yossato/Watzhdog/README.md

# Watzhdog
This device wakes you up when you fall a sleep while you are meeting, studing or working, using a vibration motor.
