yossato/Watzhdog/3D_models/Watzhdog_Pen.step

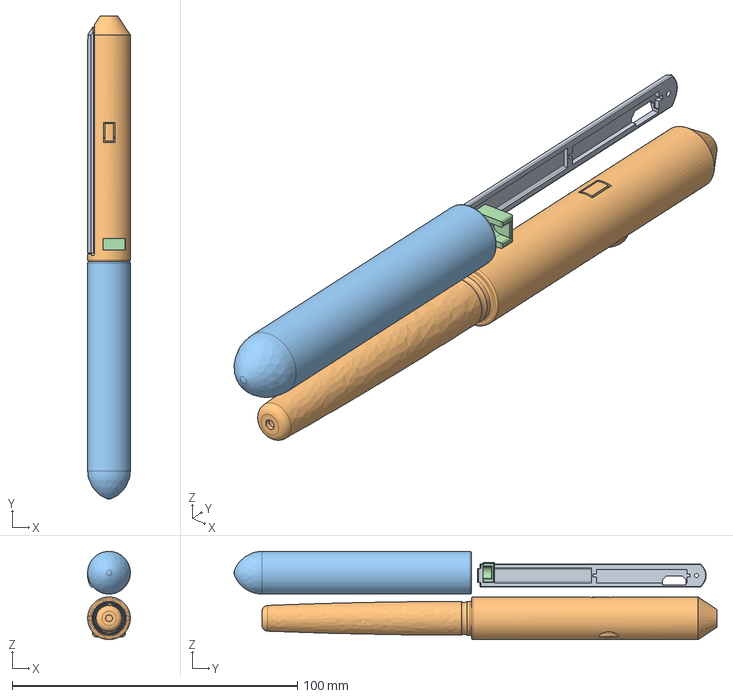
[picture p1: CAD file, 2018-08-12]
3D_models/Watzhdog_Pen.step
15.0 x 169.5 x 31.0 mm
