yossato/Watzhdog/circuit/main.brd

## EAGLE design circuit/main.brd (2018-08-12)

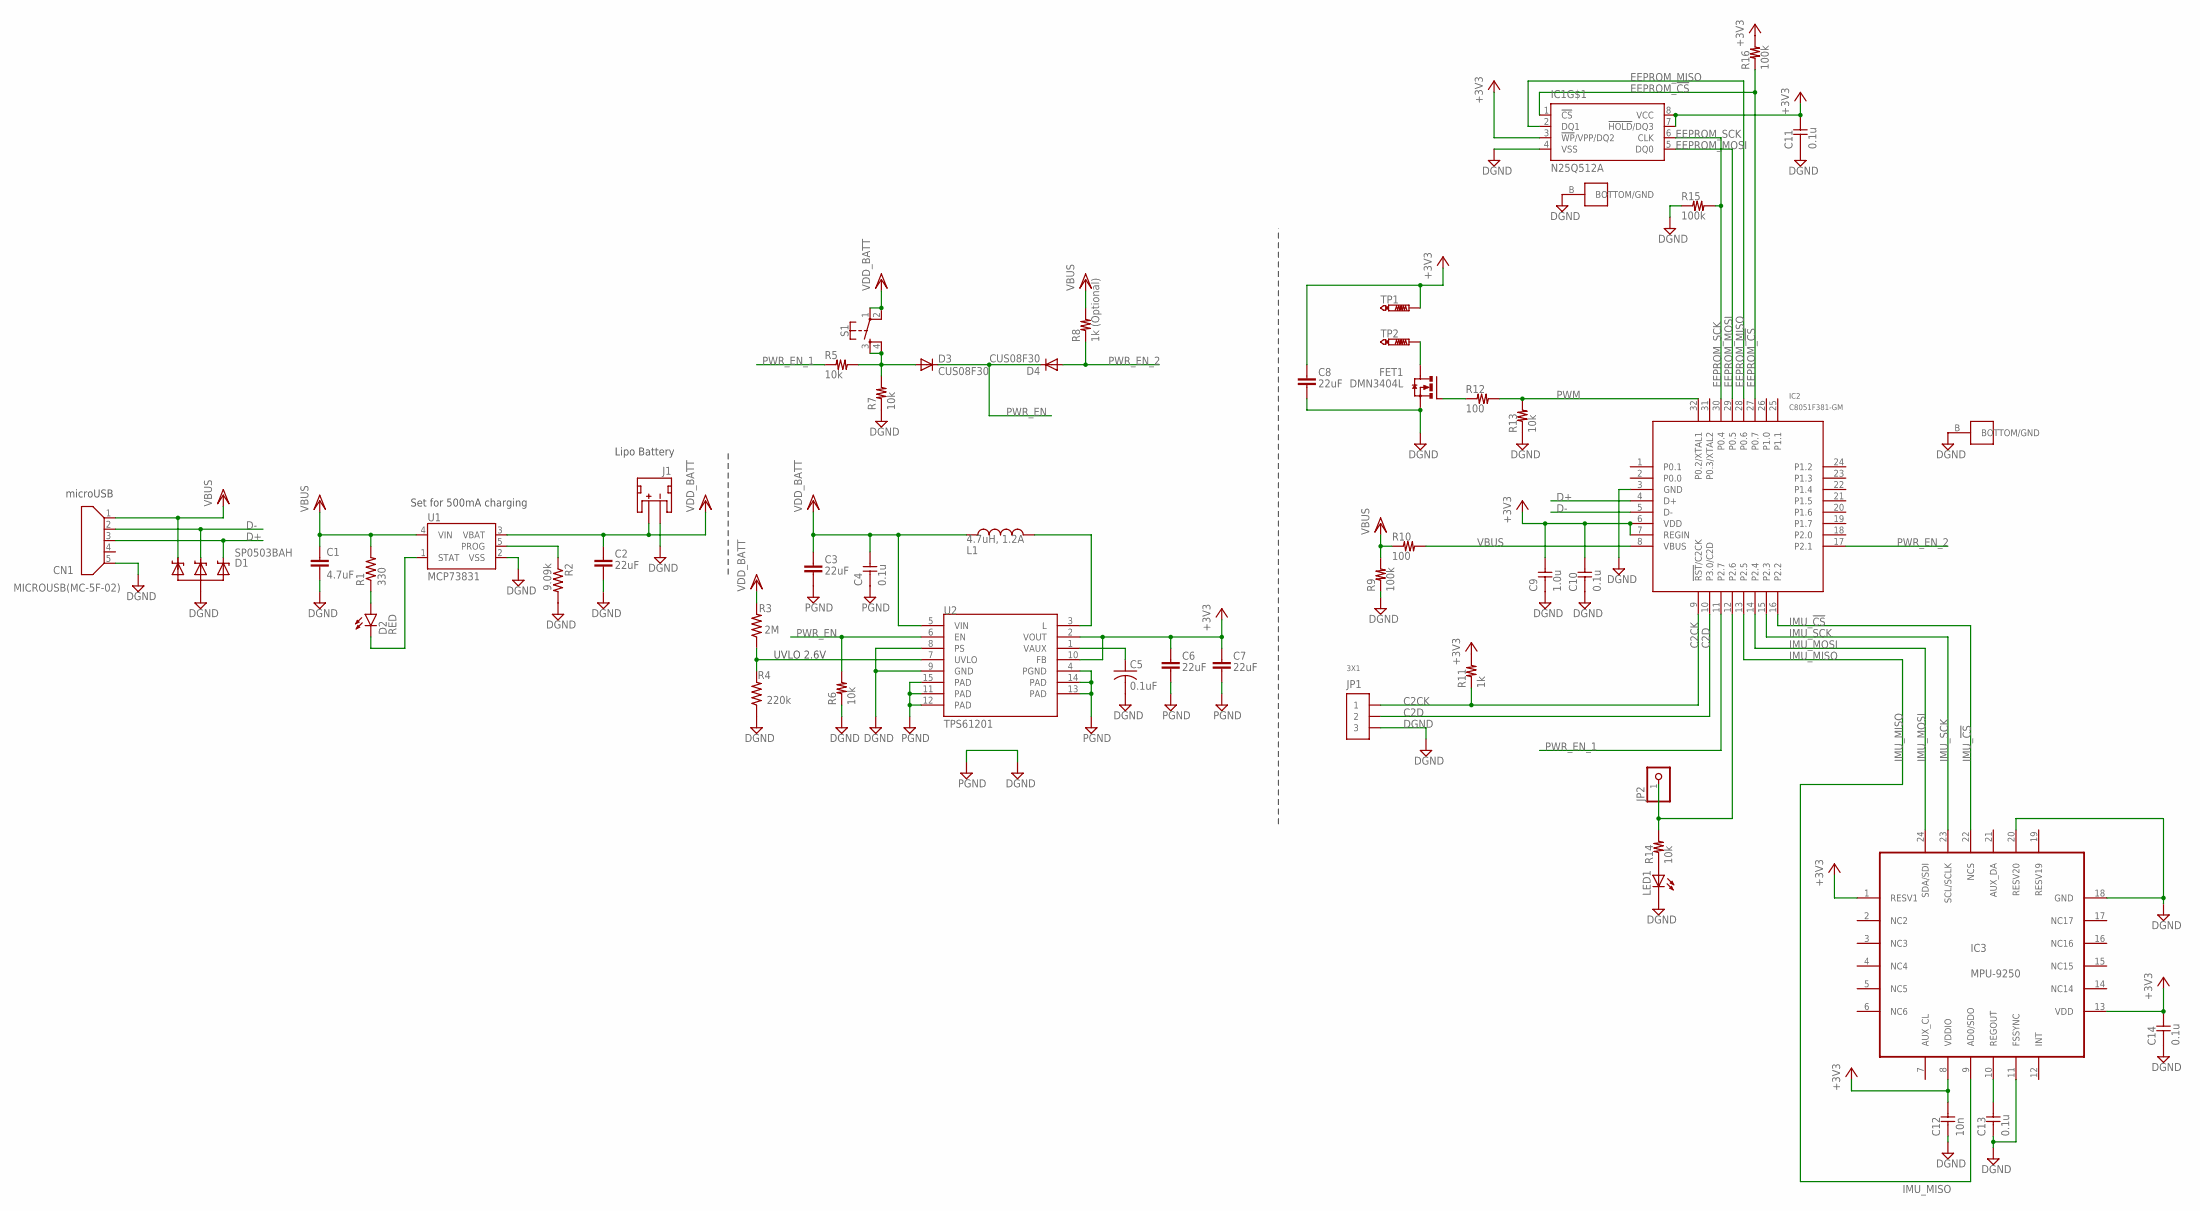
[picture p2: schematic main.sch]

Parts:
C1: 4.7uF; 0603-CAP
C2, C3, C6, C7, C8: 22uF; 0805
C4, C10, C11, C13, C14: 0.1u; 1005
C5: 0.1uF; C0402K
C9: 1.0u; 1005
C12: 10n; 1005
CN1: MICROUSB(MC-5F-02)
D1: SP0503BAH; SOT143
D2: RED; LED-0603
D3, D4: CUS08F30; SOD323-W
FET1: DMN3404L; SOT23
IC1: N25Q512A; V-PDFN-8
IC2: C8051F381-GM; QFN32
IC3: MPU-9250; QFN-24
J1: JST; JST-2-SMD
JP1: 3X1; MA3-1
JP2: PINHD-1X1; 1X01
L1: 4.7uH, 1.2A; CDRH2D09
LED1: LED1608O; 1608-OLI
R1: 330; R0402
R2: 9.09k; R0402
R3: 2M; R0402
R4: 220k; R0402
R5, R6, R7, R13, R14: 10k; 1005
R8: 1k (Optional); 1005
R9, R15, R16: 100k; 1005
R10, R12: 100; 1005
R11: 1k; 1005
S1: MOMENTARY-SWITCH-SPST-2-SMD-4.6X2.8MM; TACTILE_SWITCH_SMD_4.6X2.8MM
TP1, TP2: PTR1TP10R; TP10R
U1: MCP73831; SOT23-5
U2: TPS61201; QFN-10_PAD

Connections:
+3V3: C6.1, C7.1, C8.1, C9.P$2, C10.P$2, C11.P$2, C12.P$2, C14.P$2, IC1.3 (!WP!/VPP/DQ2), IC1.7 (!HOLD!/DQ3), IC1.8 (VCC), IC2.6 (VDD), IC2.7 (REGIN), IC3.1 (RESV1), IC3.8 (VDDIO), IC3.13 (VDD), R11.P$2, R16.P$2, TP1.TP, U2.2 (VOUT), U2.10 (FB)
C2CK: IC2.9 (!RST!/C2CK), JP1.1, R11.P$1
C2D: IC2.10 (P3.0/C2D), JP1.2
D+: CN1.3, D1.2, IC2.4 (D+)
D-: CN1.2, D1.3, IC2.5 (D-)
DGND: C1.2, C2.2, C3.2, C4.P$1, C5.2, C6.2, C7.2, C8.2, C9.P$1, C10.P$1, C11.P$1, C12.P$1, C13.P$1, C14.P$1, CN1.5, D1.1, FET1.S, IC1.4 (VSS), IC1.B (BOTTOM/GND), IC2.3 (GND), IC2.B (BOTTOM/GND), IC3.11 (FSSYNC), IC3.18 (GND), IC3.20 (RESV20), J1.1 (-), JP1.3, LED1.K, R2.2, R4.1, R6.P$1, R7.P$1, R9.P$1, R13.P$1, R15.P$1, U1.2 (VSS), U2.4 (PGND), U2.8 (PS), U2.9 (GND), U2.11 (PAD), U2.12 (PAD), U2.13 (PAD), U2.14 (PAD), U2.15 (PAD)
EEPROM_!CS: IC1.1 (!CS), IC2.27 (P0.7), R16.P$1
EEPROM_MISO: IC1.2 (DQ1), IC2.28 (P0.6)
EEPROM_MOSI: IC1.5 (DQ0), IC2.29 (P0.5)
EEPROM_SCK: IC1.6 (CLK), IC2.30 (P0.4), R15.P$2
IMU_!CS: IC2.16 (P2.2), IC3.22 (NCS)
IMU_MISO: IC2.13 (P2.5), IC3.9 (AD0/SDO)
IMU_MOSI: IC2.14 (P2.4), IC3.24 (SDA/SDI)
IMU_SCK: IC2.15 (P2.3), IC3.23 (SCL/SCLK)
LIN: L1.P$1 (1), U2.3 (L)
unnamed: D2.A, R1.1
unnamed: FET1.G, R12.P$1
unnamed: LED1.A, R14.P$1
unnamed: FET1.D, TP2.TP
unnamed: D3.A, R5.P$2, R7.P$2, S1.3, S1.4
unnamed: C13.P$2, IC3.10 (REGOUT)
unnamed: IC2.12 (P2.6), JP2.1, R14.P$2
unnamed: IC2.8 (VBUS), R10.P$2
PROG: R2.1, U1.5 (PROG)
PWM: IC2.32 (P0.2/XTAL1), R12.P$2, R13.P$2
PWR_EN: D3.C, D4.C, R6.P$2, U2.6 (EN)
PWR_EN_1: IC2.11 (P2.7), R5.P$1
PWR_EN_2: D4.A, IC2.17 (P2.1), R8.P$1
STAT: D2.C, U1.1 (STAT)
UVLO: R3.1, R4.2, U2.7 (UVLO)
VAUX: C5.1, U2.1 (VAUX)
VBUS: C1.1, CN1.1, D1.4, R1.2, R8.P$2, R9.P$2, R10.P$1, U1.4 (VIN)
VDD_BATT: C2.1, C3.1, C4.P$2, J1.2 (+), L1.P$2 (2), R3.2, S1.1, S1.2, U1.3 (VBAT), U2.5 (VIN)

Notes on the sheet:
Set for 500mA charging
microUSB
Lipo Battery
UVLO 2.6V

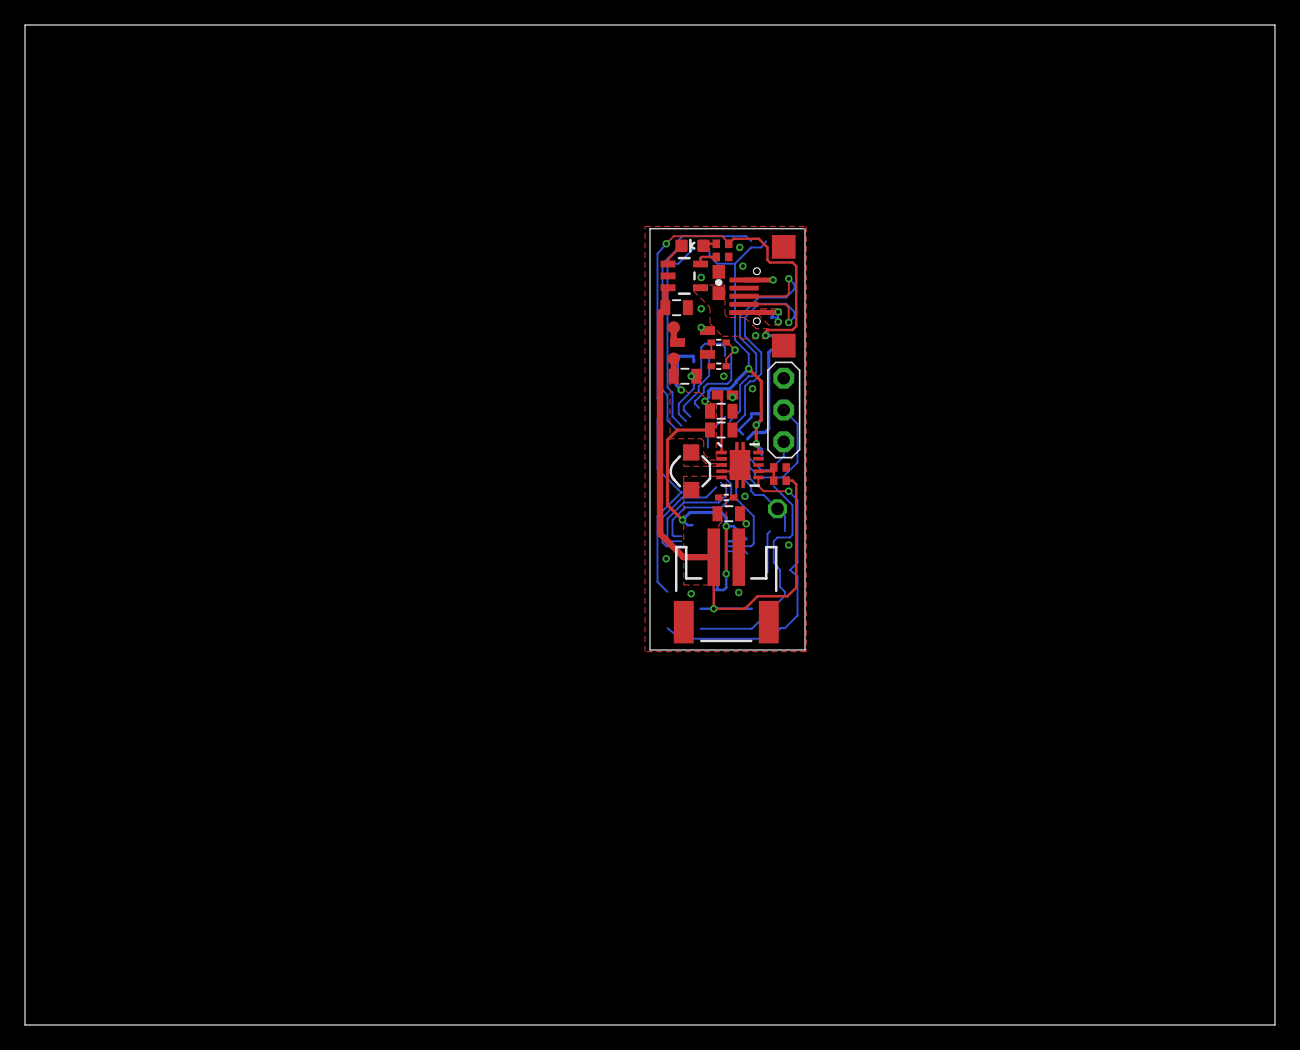
[picture p3: board main.brd from above]

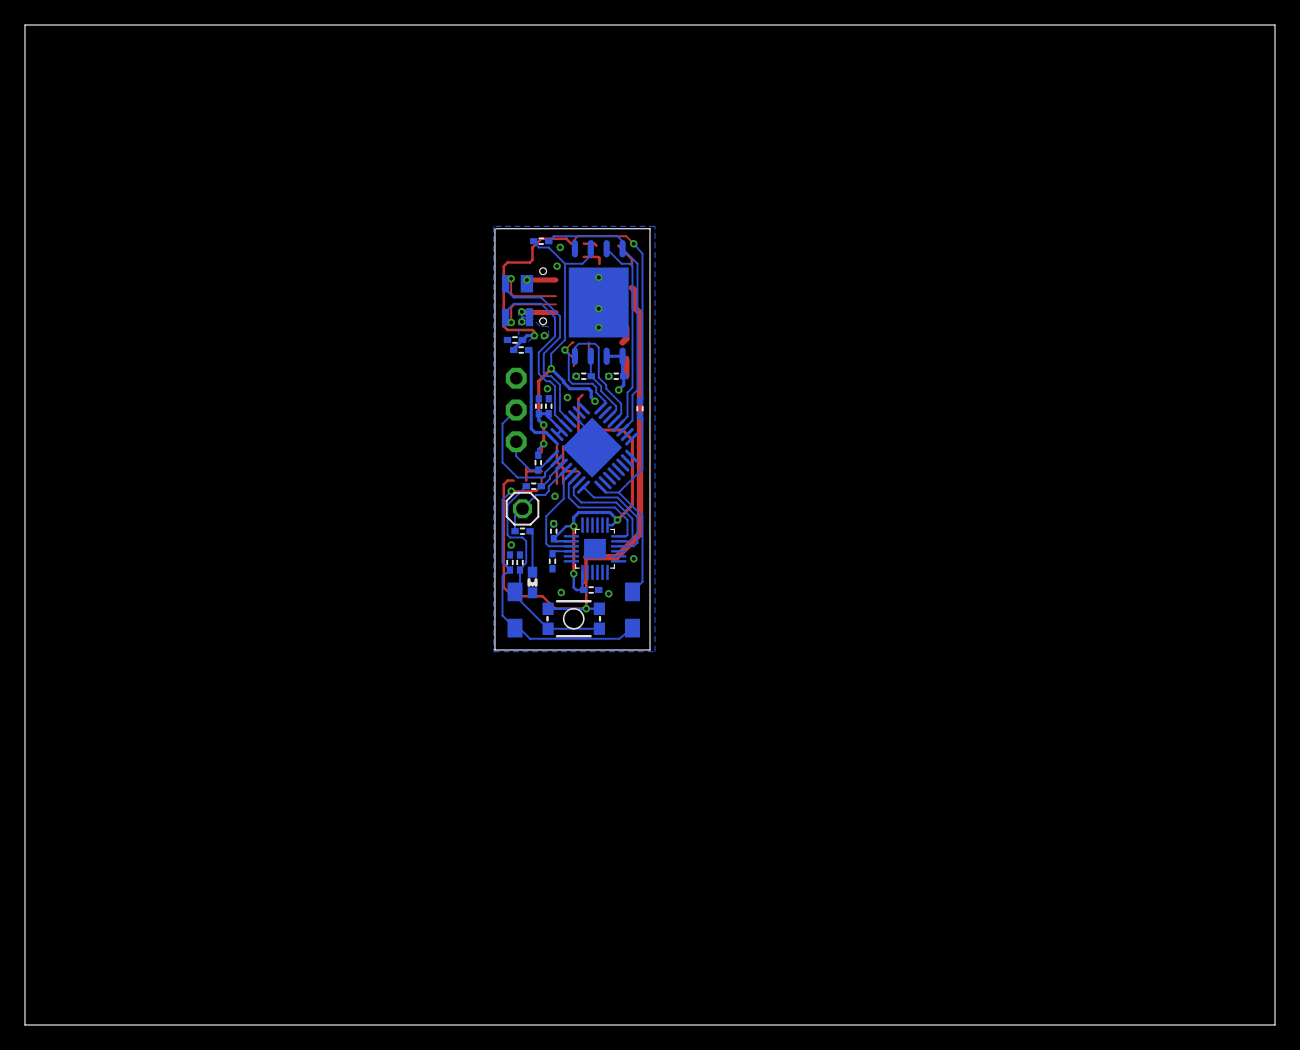
[picture p4: board main.brd from below]

Board: 2 copper layers, 100.0 x 80.0 mm, 49 parts (25 on the bottom side), 33 nets.
