yossato/Watzhdog/(commit log)

2018-04-15 Added circuit schematic
    [main.brd, main.sch]
2018-04-16 Added MCU, Gyro and Flash memory
    [main.sch]
2018-04-17 Modified circuit
    [main.brd, main.sch]
2018-05-04 Put MCU, Gyro and Flash on a board
    [main.brd]
2018-05-05 Puttin parts
    [main.brd, main.sch]
2018-05-06 Modified parts places
    [main.brd, main.sch]
2018-05-12 Modified circuit and filename
    [main.brd, main.sch]
2018-05-14 Routed some airwires
    [main.brd, main.sch]
2018-05-16 Modified parts' position
    [main.brd]
2018-05-26 Modified board artwork
    [main.brd]
2018-05-26 Modified dc-dc converter curcuit
    [main.brd, main.sch]
2018-05-26 Modified curcuit
    [main.brd]
2018-05-27 Modified curcuit as a 2-layer board
    [main.brd, main.sch]
2018-06-05 Modified parts position
    [main.brd, main.sch]
2018-06-06 Zero airwire
    [main.brd]
2018-06-06 Modified circuit shape
    [main.brd]
2018-06-13 回路図修正完了 モジュールごとに見やすくした DCDC の高周波ラインを分離 各所パスコン追加 EEPROM のCS ラインにプルアップ追加
    [main.brd, main.sch]
2018-06-15 部品配置の再検討中 SW電源，充電IC，USB インターフェース周りは完了 残：モータFET，マイコン，周辺IC
    [main.brd, main.sch]
2018-06-17 USBコネクタの角度を変更 ピンヘッダの大きさを再検討
    [main.brd]
2018-06-17 ピンヘッダのサイズで部品配置を決定する
    [main.brd, main.sch]
2018-06-19 GND 以外の配線概ね終了 PGNDとDGND を接合する準備を開始
    [main.brd, main.sch]
2018-06-19 PGND，DGND 以外の配線，ポリゴン貼り完了
    [main.brd]
2018-06-19 airwire 0 本 GND 含めポリゴン貼り完了
    [main.brd, main.sch]
2018-06-19 基板サイズ最適化 長さ：37.5mm → 33.7mm 幅：12.7mm → 12.4mm
    [main.brd]
2018-06-20 シルク調整完了 スペースがないため，すべてを表示できないため，ガーバー出力はしない方が良さそう
    [main.brd, main.sch]
2018-06-21 ガーバー発注時（実装サービスあり）のサンプルreadme テキストを追加
2018-06-22 Modified drill hole diameter
    [main.brd, main.sch]
2018-06-22 Modified board to enable thermal of polygon
    [main.brd]
2018-08-03 Uploaded 3D models
    [Watzhdog_Pen.step]
2018-08-03 removed unused stuff
    [Li_Power_Boost_Converter.brd, Li_Power_Boost_Converter.sch, SparkFun_Lipo_Charger_Basic-microUSB_v10.brd, SparkFun_Lipo_Charger_Basic-microUSB_v10.sch, Watzhdog_Pen.step]
2018-08-03 Added firmware directory
    [Watzhdog_Pen.step]
2018-08-12 Modified PGND air wire
    [main.brd]
2018-08-12 Removed gerber that contains air wire error
2018-08-12 Moved directory
    [Watzhdog_Pen.step, main.brd, main.sch]
